nredd/mind-palace-dust-hood/docs/images/exploded.png

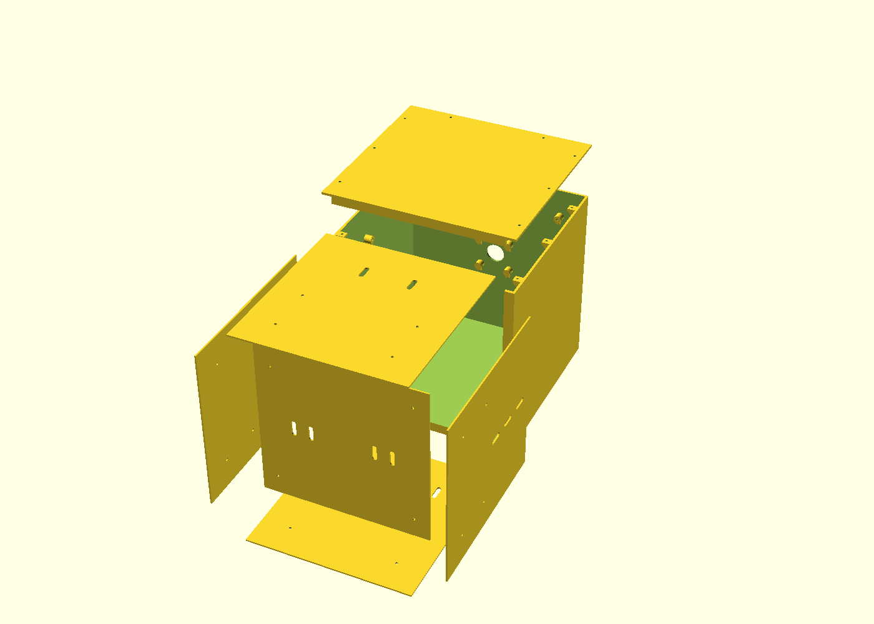
docs/images/exploded.png
