nredd/mind-palace-dust-hood/docs/images/section.png

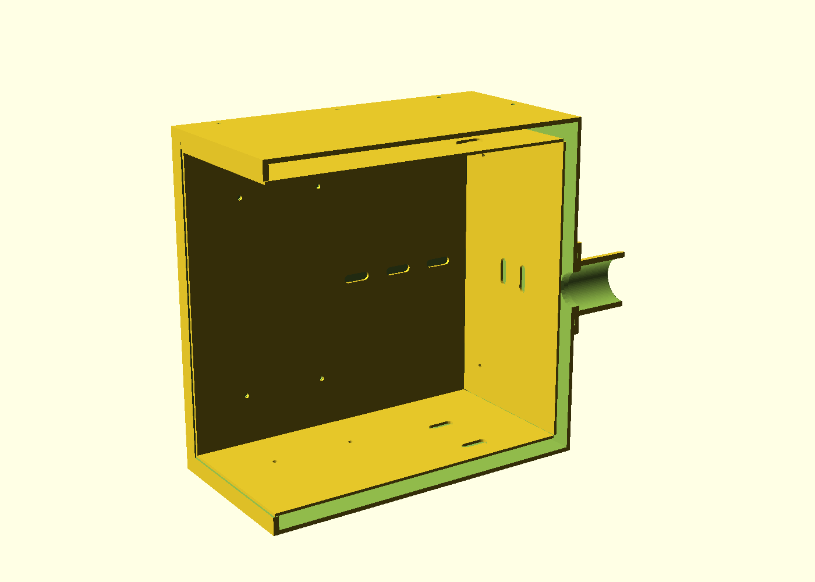
docs/images/section.png
