nredd/mind-palace-dust-hood/exports/overlay-shroud.stl

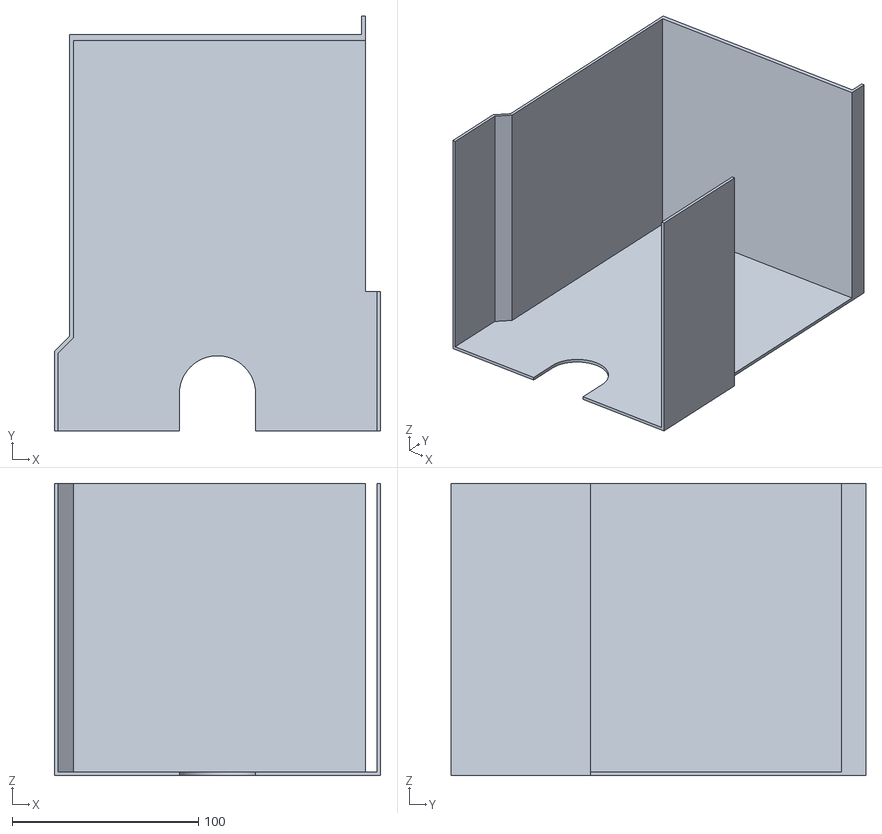
[picture p9: CAD file, 2026-10-14]
exports/overlay-shroud.stl
175.2 x 223.0 x 157.0
