nredd/mind-palace-dust-hood/exports/compact-hood.stl

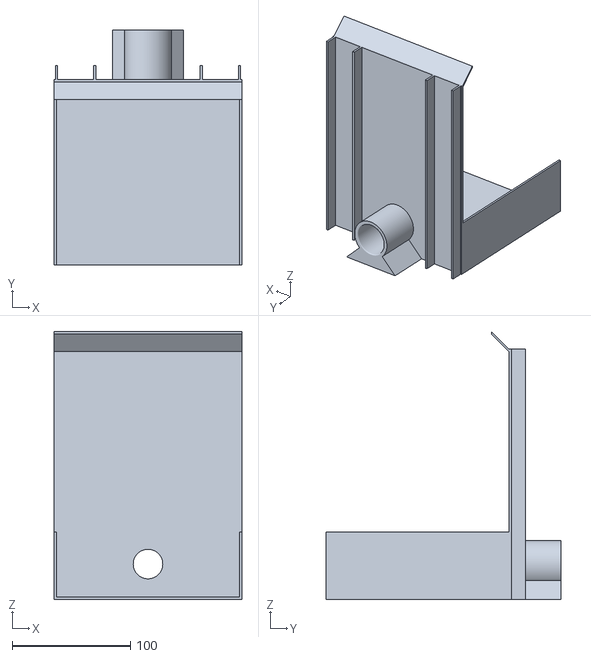
[picture p10: CAD file, 2026-10-14]
exports/compact-hood.stl
159.0 x 199.0 x 227.0
