nredd/mind-palace-dust-hood/exports/side_liner.stl

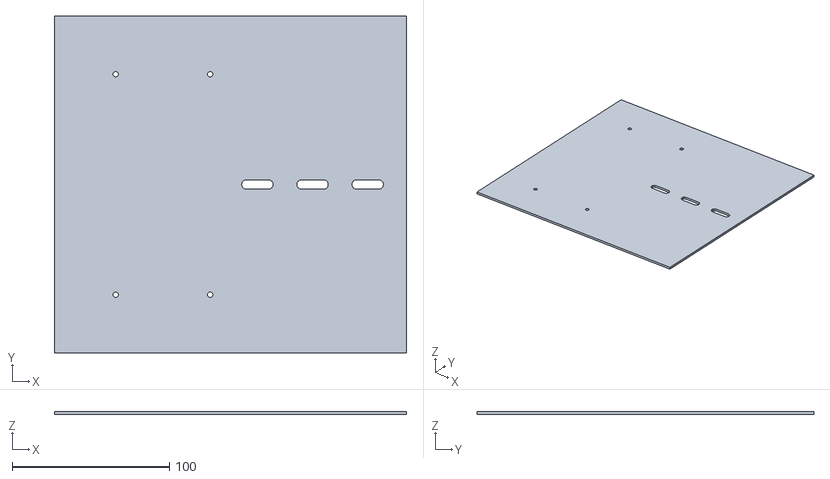
[picture p11: CAD file, 2026-10-14]
exports/side_liner.stl
223.8 x 214.0 x 2.00
