nredd/mind-palace-dust-hood/slicer/roof-p2s-petg-translucent.3mf

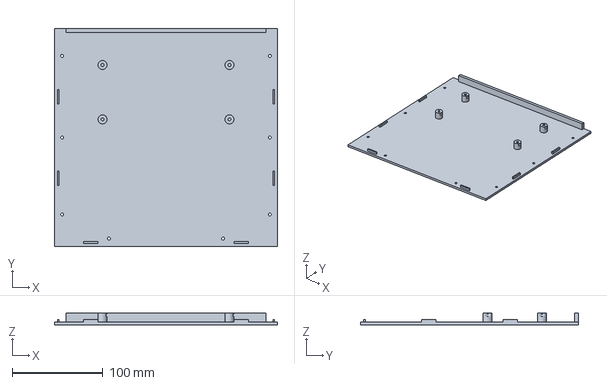
[picture p12: CAD file, 2026-10-14]
slicer/roof-p2s-petg-translucent.3mf
246.0 x 240.0 x 12.7 mm
