nredd/mind-palace-dust-hood/exports/joint_coupon.stl

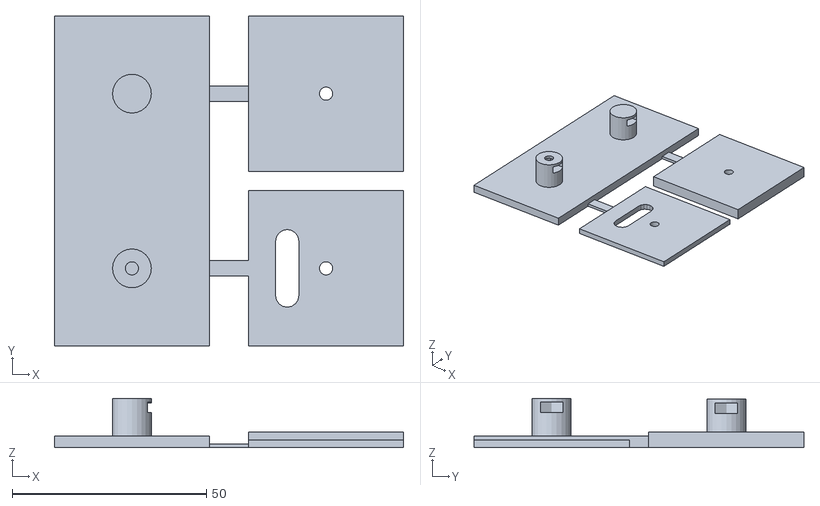
[picture p13: CAD file, 2026-10-14]
exports/joint_coupon.stl
90.0 x 85.0 x 12.7
