nredd/mind-palace-dust-hood/slicer/coupons-p2s-petg-translucent.3mf

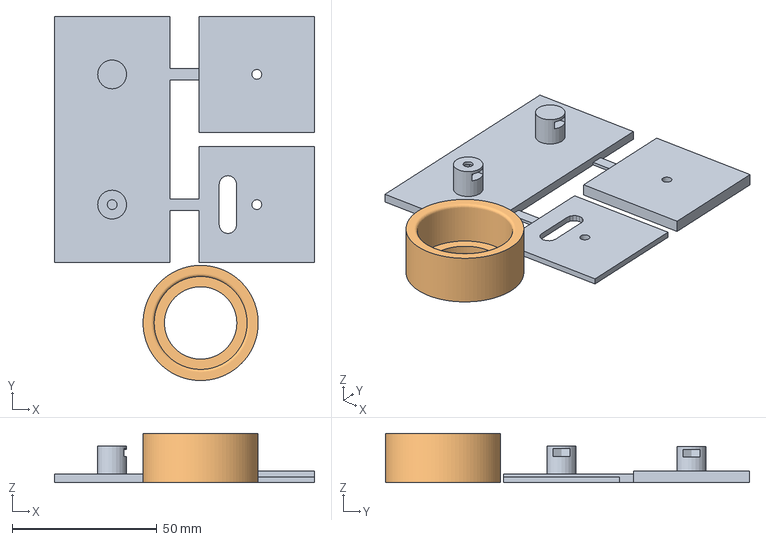
[picture p14: CAD file, 2026-10-14]
slicer/coupons-p2s-petg-translucent.3mf
90.0 x 125.8 x 17.0 mm
joint_coupon.stl
fit_coupon.stl
