nredd/mind-palace-dust-hood/exports/adapter.stl

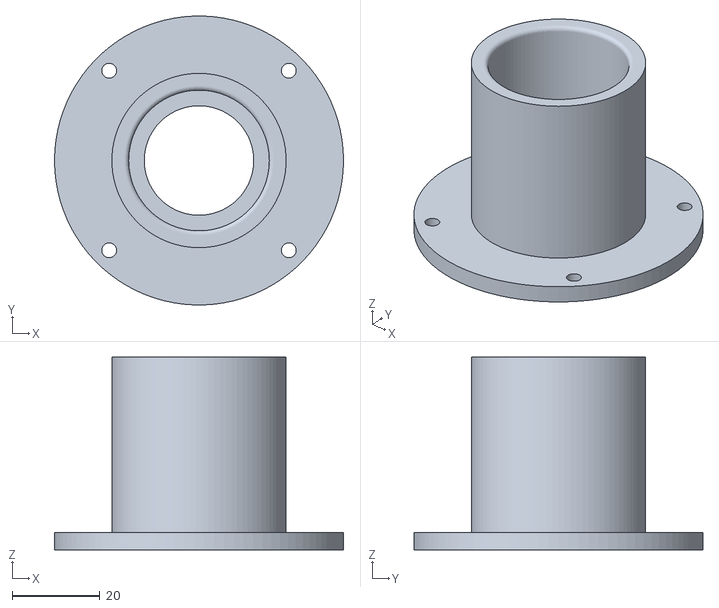
[picture p15: CAD file, 2026-10-14]
exports/adapter.stl
66.0 x 66.0 x 44.0
