nredd/mind-palace-dust-hood/exports/fit_coupon.stl

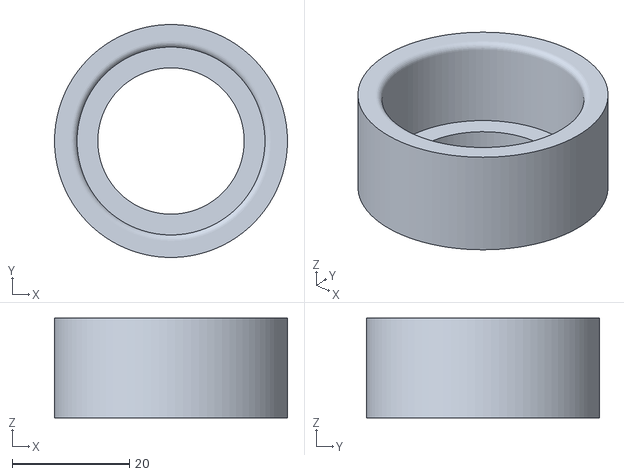
[picture p16: CAD file, 2026-10-14]
exports/fit_coupon.stl
39.8 x 39.8 x 17.0
