nredd/mind-palace-dust-hood/slicer/dust-hood-p2s-petg-translucent.3mf

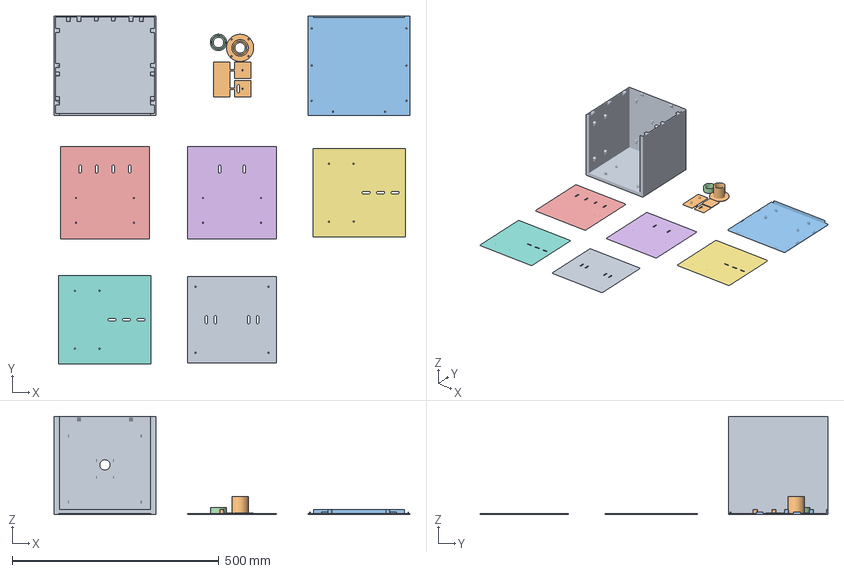
[picture p17: CAD file, 2026-10-14]
slicer/dust-hood-p2s-petg-translucent.3mf
860.4 x 841.4 x 237.0 mm
tub.stl
adapter.stl
roof.stl
fit_coupon.stl
floor_liner.stl
roof_liner.stl
side_liner.stl x 2
rear_liner.stl
joint_coupon.stl
