nredd/mind-palace-dust-hood/exports/tub.stl

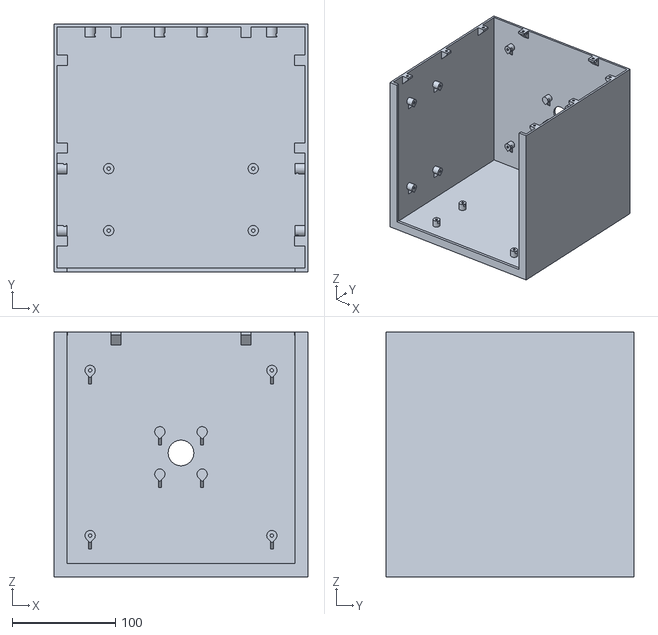
[picture p18: CAD file, 2026-10-14]
exports/tub.stl
246.0 x 240.0 x 237.0
