nredd/mind-palace-dust-hood/exports/roof_liner.stl

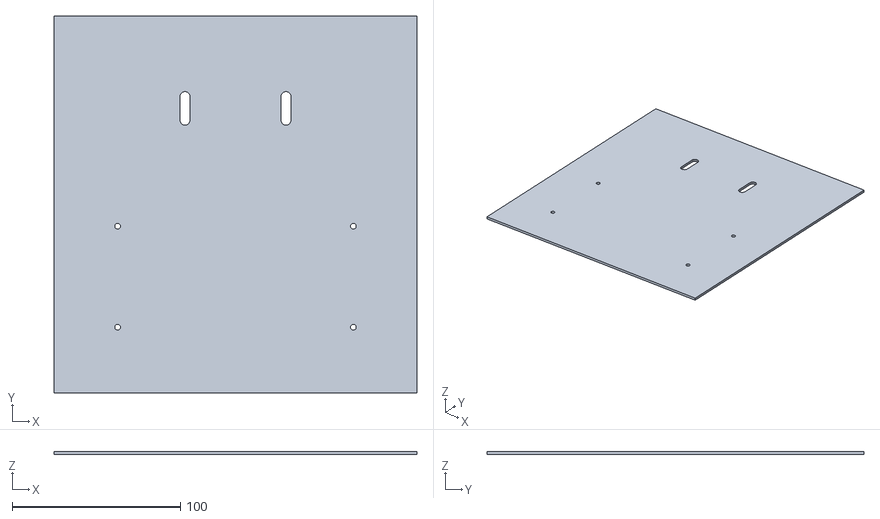
[picture p19: CAD file, 2026-10-14]
exports/roof_liner.stl
215.6 x 223.8 x 2.00
