nredd/mind-palace-dust-hood/exports/rear_liner.stl

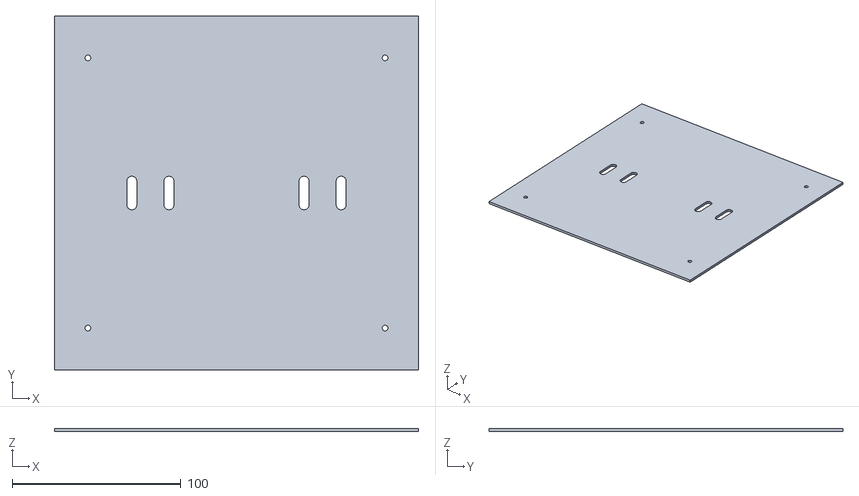
[picture p20: CAD file, 2026-10-14]
exports/rear_liner.stl
215.6 x 209.6 x 2.00
