nredd/mind-palace-dust-hood/(list of files, cad)

Other CAD files:
slicer/overlay-shroud-p2s-petg-translucent.3mf
slicer/compact-hood-experimental-p2s.3mf
slicer/p2s-petg-translucent-settings.3mf
exports/roof.stl
exports/floor_liner.stl
