nredd/mind-palace-dust-hood/docs/images/assembly.png

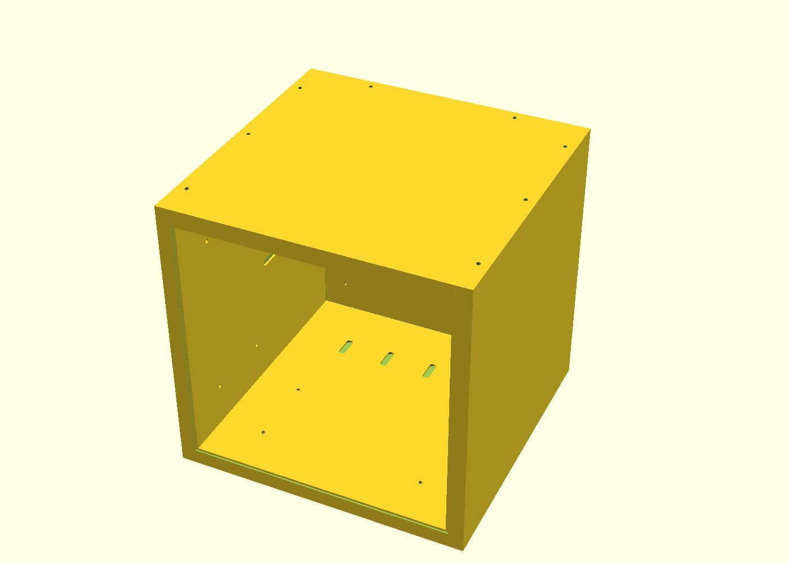
docs/images/assembly.png
