nredd/mind-palace-dust-hood/(commit log)

2026-10-14 Add the unprinted OpenSCAD dust hood prototype
    Preserve the original CAD and reproducible geometry checks while physical fit, capture performance and detailed toolpath inspection remain unverified. The Fusion checkpoint and restricted reference downloads stay local.
    [adapter.stl, coupons-p2s-petg-translucent.3mf, dust-hood-p2s-petg-translucent.3mf, dust-hood.scad, fit_coupon.stl, floor_liner.stl, joint_coupon.stl, p2s-petg-translucent-settings.3mf]
2026-10-14 Add a compact monolithic hood candidate
    The eight-plate design exceeded the user's print budget. Preserve it for comparison while reducing the footprint and opening side access for long and awkward tools. The new slice meets the numerical budget but remains experimental because Bambu excludes PETG Translucent from its PLA support guide.
    [compact-hood-experimental-p2s.3mf, compact-hood.scad, compact-hood.stl]
2026-10-14 Record the existing collector interface for an overlay shroud
    The new shroud must mate to the user's existing print, whose 170 x 130 mm body and rising rear rim differ from the 155 mm working envelope. Record source-derived functional dimensions without copying restricted geometry or claiming the overlay is implemented.
2026-10-14 Add a single-material overlay shroud for the existing collector
    Keep the printed collector and its hose connection instead of replacing them. A table-supported cover avoids loading or tracing the irregular rim, while rear-face-down printing avoids the support interface problem. The table edges and hose crossing still require removable seals and physical validation.
    [overlay-shroud.scad, overlay-shroud.stl]
2026-10-14 Save and verify the single-material overlay print project
    The rear-face-down PETG Translucent slice reproduces 11h03m and 270.63 g after reopening, without supports or filament changes. Preserve the project and observed estimate while distinguishing slicer evidence from untested fit, seals and print stability.
    [overlay-shroud-p2s-petg-translucent.3mf]
